maksimod/automatic_system_school_rings/README.md

# automatic_system_school_rings
автоматическая система школьных звонков
