maksimod/automatic_system_school_rings/(commit log)

2024-02-24 код устройства
2024-02-24 код приложения
2024-02-24 пояснительная записка
2024-02-24 3д модель корпуса
2024-04-09 демонстрация работы прибора
2024-04-10 Update ring.pde
    Теперь пользователь не сможет вводить "странное" время наподобие "99:78"
